werneckpaiva/TankEsp32/3d-model/.superpowers/sdd/2026-10-20-gimbal-head/progress.md

# SDD ledger — plan: esp32s3cam/docs/superpowers/plans/2026-10-20-gimbal-head.md
Spec: esp32s3cam/DESIGN.md
Setup: Ruling: no git repo — ledger kept by hand, no commits/BASE, task-start/task-done scripts not used; completion = suite run recorded here — cost if wrong: no per-task diff history (user can git init later)
Pre-flight:
- T2→T3..T7 components frames (board/servo/bearing/horn) — consistent
- T3→T4 NECK_TOP_Z, PAN_SERVO_LOC — consistent
- T4→T5 STUB_D(b), PAN_BEARING_LOC — consistent
- T5→T6 ARM_INNER_X — consistent
- T6→T7 BOARD_LOC/SR04_LOC/LASER_LOC + components.sd_access/usb_plug — consistent
- T8→T9 printed_parts(), NEEDS_SUPPORT — consistent
- Modules must read params via `import params as p` (T7 note) — applies to all tasks
Task 1: complete (tests: ../.venv/bin/python -m pytest tests -q → 4 passed)
Task 2: complete (tests: ../.venv/bin/python -m pytest tests -q → 12 passed). Added test_board_sd_on_plus_x_side, test_horn_hub_on_axis (extra coverage).
Task 3: Ruling: neck is a round drum (inner r = max(servo-tab reach 22.5+FIT, coupler sweep+MOVE_CLR, wire slot)) lofting out from the plate outline; it overhangs the plate (≈Ø49) — a narrow neck cannot hold the tabs and the horn sweep and leave a wire path — cost if wrong: bulkier "turret ring" look; plate footprint/holes unchanged.
Task 3: Ruling: plan's test_footprint/test_long_axis_switch bbox asserts replaced by z=1 plate-outline probes + bbox ≤ drum Ø — drum overhangs by design — cost if wrong: none functional.
Task 3: Ruling: long-axis switch rotates the whole base incl. servo pose; added pan_servo_loc(long_axis), PAN_SERVO_LOC = default — servo must follow the plate's long side — cost if wrong: one function.
Task 3: Ruling: pan servo stands on the plate top, held by tab screws into a front pillar and a rear ledge off the drum wall (rear pillar would block its cable exit) — cost if wrong: re-shape a ledge.
Task 3: complete (tests: ../.venv/bin/python -m pytest tests -q → 23 passed)
Task 4: Ruling: wires cross the pan joint through a hole in the co-rotating horn coupler and an arc slot in the neck-cap ceiling over the FRONT half (rear is crowded by the servo/tabs); test probes rotated to +Y and taken at pan.WIRE_SLOT_Z (ceiling) instead of NECK_TOP_Z+1 — cost if wrong: wire path rework.
Task 4: Ruling: the stub belongs to the coupler (passes up through the bearing), the yoke has a keyed socket fixed by one central M2 screw; no horn centre screw (bearing stack holds the horn on the spline). STUB_D(b) kept as the shared dimension — cost if wrong: horn could creep off the spline if the stack is loose.
Task 4: Ruling: components.mg90s_horn(grow=0.0) gains a grow parameter to cut pockets with FIT — cost if wrong: none.
Task 4: complete (tests: ../.venv/bin/python -m pytest tests -q → 33 passed)
Task 5: Ruling: added params.HEAD_WALL; ARM_INNER_X = SR_W/2 + FIT + HEAD_WALL + MOVE_CLR so the whole head (eye section is the widest) fits between the arms and the arms never meet the head at any tilt — cost if wrong: ~82 mm overall width instead of ~72.
Task 5: Ruling: no printed load ring around the tilt servo horn (spec "should") — the head sits between a bearing and the MG90S output (which has its own bearing); a ring would need a large-diameter sliding face inside the horn sweep — cost if wrong: some radial load on the tilt servo shaft.
Task 5: bug found in Task 4 code (stub flat box mis-aligned, cut half the stub) — test_stub_has_one_flat RED→GREEN.
Task 5: complete (tests: ../.venv/bin/python -m pytest tests -q → 44 passed). TILT_AXIS_Z uses HEAD_DROP=28 mm, to be tuned in Task 7.
Task 6: Ruling: the +X axle collar (touches the tilt bearing's inner ring) is exempt from test_fits_between_arms; the test excludes a cylinder of r = bore/2 + 1.5 around the tilt axis — the collar is the intended joint — cost if wrong: none.
Task 6: Ruling: no ribs pressing the camera board from behind (they would sit in the Dupont bay); the board is held on snug standoff pins and the plugs push it forward. HC-SR04 is held by its cans against the front wall + pegs on the rear cover at its corners — cost if wrong: a dab of glue.
Task 6: Ruling: components.hcsr04_keepout back box shrunk to the component area (corners are mounting-hole area, free) so the pegs can press the corners — cost if wrong: none.
Task 6: Ruling: rear cover = back plate only (split at the back wall's inner face) so no functional pocket is split across parts; horn pocket tilted 35° in the YZ plane to fit inside the head depth/height — cost if wrong: none.
Task 6: complete (tests: ../.venv/bin/python -m pytest tests -q → 60 passed). Body half-width widened by 1 mm for cover-screw posts; inner cavity corners square, outer rounding 2.5 mm.
Task 7: tuned yoke.HEAD_DROP 28 → 26 mm (24 fails at tilt −45° with 0.07 mm gap, 25 is the sampled minimum; 1 mm kept for angles between the 15° samples). Verified the motion test detects clashes (drop 18/22 → gaps 0.00).
Task 7: complete (tests: ../.venv/bin/python -m pytest tests -q → 96 passed; run_checks passes)
Task 8: found 0.2 mm floor under the yoke's central screw head — test_screw_head_has_a_floor RED→GREEN by BAR_T = SOCKET_DEPTH + 3.5 (was +2); head rises 1.5 mm.
Task 8: complete (tests: ../.venv/bin/python -m pytest tests -q → 105 passed; gimbal_head.py ran: checks pass, 6 STLs written, viewer not running → logged, exit 0). Ruling: yoke prints lying on its servo arm's outer face (its foot gives <50 mm² of bed contact upright) — cost if wrong: a reprint orientation choice in the slicer.
Task 9: complete (tests: ../.venv/bin/python -m pytest tests -q → see final run; make_3mf.py → gimbal_head.3mf, 1 plate, ~5.2 h, 84 g PLA)
Final review: fresh reviewer (opus). 2 Critical, 9 Important, ~12 Minor. Re-graded: C1 wire path across tilt joint, C2 floating posts → fix. I3 assembly order, I4 pan key backlash, I5 wire hole sizing/margin, I6 HEAD_DROP derived, I7 face-down print on brows, I8 bushing binding, I9 servo cable hole, I10 tab-screw length → fix. I11 overall height 143 mm → user decision (Ruling below).
Final: fixed C1 wire path across tilt joint — wires now cross the pan joint at WIRE_ANGLE=180 (-X); head exit in the underside straight above the yoke hole; 4 mm well around the hole; tilt-servo cable tunnel through the crossbar — test_head_wire_exit_above_yoke_hole, test_wire_corridor_never_pinched (fails at 0.93 mm without the well), test_servo_cable_tunnel_open RED→GREEN.
Final: fixed C2 floating cover posts — posts run into ceiling/floor — test_printed_parts_have_no_loose_pieces RED→GREEN.
Final: fixed I3 tilt/horn assembly order — docstring rewritten (horn into head pocket, axle, then servo slides in from outside; pan horn set on the spline first). Docs only, no test.
Final: fixed I4 pan key backlash — 2.0 mm flat with 0.1 mm fit — test_stub_key_has_little_play RED→GREEN (≤2°).
Final: fixed I5 wire holes — sized from WIRE_COUNT·WIRE_D at WIRE_FILL 0.4 and to pass a 3-pin plug, cap slot +15° margin each end — test_wire_hole_sized_for_bundle_and_plug, test_cap_slot_has_end_margin RED→GREEN. Pan horn pocket turned to WIRE_ANGLE+90 to clear the hole; cap ceiling 3 mm, seat lip 1 mm (spacer 1.5 mm).
Final: fixed I6 HEAD_DROP — derived from head.drop_below_axis() (2.5° sweep); head no longer imports yoke — test_rebuilds_with_perturbed_params[BAY_DEPTH] RED→GREEN (also now checks tilt overlap).
Final: fixed I7 face-down print — brow rings are a separate part plugged into the eye openings — test_head_front_face_lies_on_the_bed RED→GREEN.
Final: fixed I8 pan bushing binding — bushing 0.6 mm shorter than the bearing (stub bottoms out first) — test_bushing_is_shorter_so_it_is_not_clamped RED→GREEN.
Final: Ruling: tilt bushing can still be clamped by the M3 axle — documented "don't overtighten" instead of redesigning the axle stack — fallback mode only, bearings are the default — cost if wrong: stiff tilt in bushing mode.
Final: fixed I9 pan-servo cable hole — 8.5 × 4.5, 2.5 mm from the plate edge — test_servo_cable_hole_takes_plug_and_keeps_an_edge RED→GREEN.
Final: fixed I10 tab screws — docstring limits them to 6 mm. Docs only.
Final: Ruling: I11 overall height ~145 mm vs 110–125 target — left to the user (needs a design change: sinking the pan servo into the tank cover, or a shorter stack) — cost if wrong: looks tall on the tank.
Final: minor (deferred): camera board held only by snug pins (no rear retention)
Final: minor (deferred): HC-SR04 pegs 2×2×22 mm are fragile
Final: minor (deferred): HC-SR04 cans sit behind the face (brow rings now frame them)
Final: minor (deferred): neck-cap screw counterbores leave ~0.14 mm outer wall
Final: minor (deferred): pan seat hangs from a partial ceiling (ceiling now 3 mm, lip 1 mm)
Final: minor (deferred): 623 shields may rub on collar / M3 head
Final: minor (deferred): TILT_AXLE_D unused; axle pilot fixed at Ø2.5
Final: minor (deferred): yoke prints tall on a narrow face (brim advised in docstring)
Final: minor (deferred): large flat −X side face runs 0.5 mm from the arm
Final: minor (deferred): no laser-vs-eye test
Final: minor (deferred): Dupont bay measured from PCB front (28.4 mm behind the board)
Final: suite 134/134 passed; gimbal_head.py motion checks pass, 7 STLs written; gimbal_head.3mf 1 plate ~5.1 h, 82 g PLA. Ruling: ledger kept (no git history to replace it).
Change (user): tilt bearing 623 → 608 (user has five 8x22x7). Ruling: tilt axle is now a separate printed pin through the 608 into a head socket, M3x25 bolt + nut inside the head; small-bore screw-axle variant dropped (bore ≥ 6 asserted) — a pin fixed to the head could not be inserted between the arms — cost if wrong: a bearing < 6 mm bore needs the old axle back. Horn pocket angle 35° → 22° (head bottom rose ~6 mm with the larger pin-arm boss). Tests RED first: test_bearing_defaults, test_axle_socket_and_bolt_hole, test_collar_touches_inner_ring_only, test_tilt_axle_fits, test_fits_between_arms, test_horn_pocket_inside_head (guard).
Change: tilt socket deepened to the pin's real length (test_tilt_axle_fits RED→GREEN). Suite 140/140; motion checks pass; 8 STLs; 3MF ~5.6 h, 91 g. Overall 83.2 × 48.7 × 145.3 mm.
Change (user): support optimisation. Measured with the slicer per part (supports on vs off): yoke 11.1 g / 40 min, head_front 1.3 g / 10 min, others ≤ 0.6 g.
- Ruling: the slim +X arm is now a separate part (pin_arm) bolted to the crossbar with 2 x M3 x 12 from below — lying on its side the yoke had a 48 mm cantilever 75 mm above the bed — cost if wrong: a bolted joint instead of one piece.
- Yoke hub: round hub → 45° shouldered hub around the wire well. Head front: 45° chamfers on the face/back outlines (edges along Y still rounded), horn bar run square to the face, 1.25:1 tapered post ends, full-length laser clamp ear block, teardrop axle boss.
- Tests: test_prints_without_support[yoke|pin_arm|head_front], test_cantilevers_are_gone, test_pin_arm_bolts_to_the_crossbar, test_tall_yoke_gets_a_brim RED→GREEN. Metric fix: angle convention (45° chamfers are fine) and small hole ceilings (r ≤ 4.5) are bridged.
- Result: no part needs supports; yoke gets a 5 mm brim. Plate: 77.6 g, 4.8 h (was 91.3 g, 5.6 h), used_for_support=false. Suite 154/154.
Change (user): yoke supports enabled in the 3MF (tree, build plate only); test_support_settings RED→GREEN. Plate 79.7 g, 5.0 h.
Change (user): base flare 45-49° → 40° from vertical inside and out (test_prints_without_support[base] RED→GREEN after tightening the test to < 10 mm² for every bare part); brims on yoke + tilt_axle from a height/√(bed contact) check (test_brims_where_parts_are_tall_for_their_footprint RED→GREEN). Suite 161/161; 3MF 79.8 g, 5.0 h; only slicer warnings left are the timelapse notices.
Change (user): base supports enabled (test_support_settings RED→GREEN).
Change: base floating starts fixed — rear tab ledge clipped to the drum's outside, neck-cap boss cones start at r 1.0 so they grow from the wall (test_base_has_no_floating_starts RED→GREEN, 19 s slice test). Base supports stay enabled at the user's request.
Change (user): stringing over holes on neck cap + brows. Neck-cap bearing lip → 0.6 mm flat step + 45° slope (test_bearing_lip_has_no_mid_air_ledge RED→GREEN); brow flange → 40°-from-vertical slope under it (test_brow_flange_slopes_instead_of_a_mid_air_ledge RED→GREEN); 3MF process: reduce_crossing_wall=1 (test_travel_avoids_crossing_holes; make_3mf.py now has a main() guard). Suite 164/164. Versus the printed 3MF: brows, neck_cap changed (this fix); base changed slightly (earlier floating-start edits, kept); all others identical.
Change (user): MG90S cable leaves the shaft end (not the far end). Base: front pillar is now an arch over the cable (ARCH = plug + clearance), cable runs to the plate's front cable hole; rear SERVO_CABLE_HOLE removed. Tilt servo checked: its cable exits into the open tab slot of the yoke arm — no change. Tests: test_pan_servo_cable_runs_under_the_front_pillar RED→GREEN, test_front_tab_screw_still_has_plastic, cable-hole sizing now includes the servo's 3 wires. Suite 165/165. Assembly guide PDF and docstring updated.
Change (user): HC-SR04 fit. User dims match params (45x20, Ø16, 10 mm gap = 26 c-c). Cause: top rear-cover posts sat in the sensor's insertion path (sweep test); board clearance only 0.25 mm. Fix: params.SR_CLR=0.5 (eye side walls 1.35 so the outside and the yoke are unchanged), board located by 4 front ribs (cans ≤ SR_TX_H+0.5 clear the wall), top cover screws now from above through the top wall into tabs on the rear cover. Tests: test_hcsr04_slides_in_from_the_open_back, test_hcsr04_has_printable_clearance, test_hcsr04_board_stops_against_front_ribs, test_rear_cover_screws_from_the_top RED→GREEN. Suite 169/169. Reprint vs printed: head_front, head_rear (+ base, neck_cap, brows from earlier fixes).
Change (user): camera alignment. Lens/LED positions measured by the user (lens centre 15.37 from left, 9.03 from top; LEDs at 9.0 and 23.4). Camera stands ~7.5 mm (block) + barrel ~8.7 mm off the board (side-photo estimate), so it hit the inside of the face (5.5 mm) and tilted the board's top end off its pins. Fix: params updated (CAM_H → CAM_BLOCK_H/LENS_TIP_H, LENS_D/LENS_D_FRONT, LED_W, VISOR_CLR), head face gap decoupled from camera height (FACE_GAP 5.5, outside unchanged), round lens + LED windows replaced by one visor window. Tests: measured values, test_visor_opens_the_face_for_the_camera_and_leds, test_outside_unchanged... RED→GREEN; suite 171/171. Reprint: head_front only.
Change (user): camera opening is now =O= (round Ø13 hole the square camera block passes through + a slot to each LED), test_camera_opening_is_round_with_led_slots RED→GREEN. New optional fit-test piece (face only: openings, board pins, HC-SR04 ribs) built from the same face_mounts()/face_openings() as the head; exported separately as gimbal_fit_test.stl, not on the main plate. Tests: test_fit_test_is_one_flat_piece, test_fit_test_matches_the_head, test_fit_test_exported_on_its_own. Suite 174/174.
Change (user): HC-SR04 cans stand out CAN_OUT=1.5 mm (SR_Y = Y_FRONT + CAN_OUT - SR_TX_H; plug keepout thickness corrected to the 2.54 mm Dupont housing; plugs keep 1.0 mm from the camera board), eye openings pass the cans, brows are plain tubes seated in a 0.8 mm recess. Fit test is now head_front cut just behind both boards (walls included, FIT_TEST_Y0). Status LED (centre 6,3 from top-left, 2 mm) window + light path through the top-left standoff; LED_WIN_CLR 1.0 margin on every LED window. Tests: test_eye_cans_stand_out_of_the_face, test_hcsr04_plugs_clear_the_camera_board, test_brows_sit_around_the_cans, test_fit_test_is_the_front_of_the_head, test_board_has_the_status_led, test_every_led_shows_through_the_face RED→GREEN. Suite 180/180. Reprint vs printed: head_front, head_rear, brows.
Change (user, after fit test): camera board FACE_GAP 5.5 → 4.8 (BAY_DEPTH 30.0 → 30.7 keeps DEPTH 38.7, yoke unchanged); measured LENS_TIP_H 7.05, USB_H 3.25, SD_SHELL_H 3.2 (was 2.0); CAM_BLOCK_H estimate lens-1.0; O = block circumscribed + 0.25 (Ø12.5); LED_Y 7.5 → 6.5; SD slot +SD_CLR 0.5; HC-SR04 held by 4 corner posts merged into walls/ceiling/floor + 4×M2×6 through its Ø2 holes (inset 1.6 from photo), rear-cover pegs and face ribs removed; 3MF nozzle 210 °C + avoid crossing walls, plus gimbal_fit_test.3mf. Tests RED→GREEN: test_measured_board_heights, test_camera_board_close_to_the_face, test_o_is_as_small_as_the_camera_block_allows, test_hcsr04_screws_to_corner_posts, test_sd_slot_has_extra_margin, test_print_settings_against_stringing, test_fit_test_has_its_own_project. Suite 186/186. Reprint: head_front, head_rear, brows.
Change (user): axle boss now starts at the head's wall (was 0.2 mm from the right header's Dupont plugs); esp32_keepout gained a header-plug zone (+1 mm beside the plugs); camera board pinned at two diagonal corners and screwed (M2x6) at the other two; rear cover has a 1.2 mm locating lip (0.2 clearance, 3 mm deep, top and sides). Exploded tilt-joint drawing added to the guide. Tests RED→GREEN: test_keepout_leaves_room_beside_the_header_plugs, test_camera_board_screwed_at_two_corners_pinned_at_two, test_rear_cover_has_a_locating_lip. Suite 189/189. Reprint: head_front, head_rear, brows. Depth question open (user decision).
