werneckpaiva/TankEsp32/3d-model/3mf/printed/2026-10-21_round_lens_window.3mf

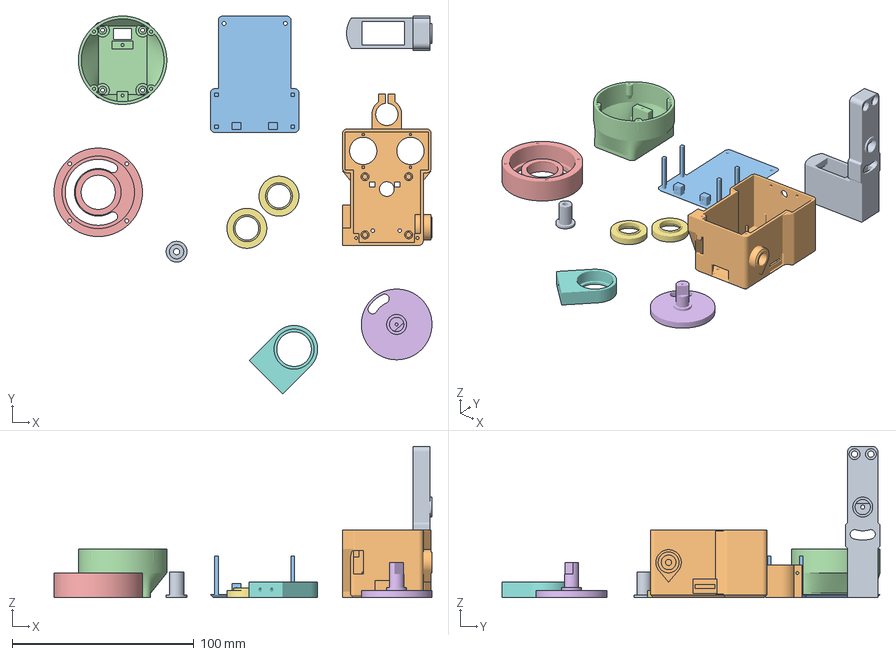
[picture p1: CAD file, 2026-10-21]
3d-model/3mf/printed/2026-10-21_round_lens_window.3mf
208.0 x 208.0 x 83.2 mm
gimbal_yoke.stl
gimbal_head_front.stl
gimbal_head_rear.stl
gimbal_base.stl
gimbal_neck_cap.stl
gimbal_pan_coupler.stl
gimbal_brows.stl
gimbal_pin_arm.stl
gimbal_tilt_axle.stl
