werneckpaiva/TankEsp32/3d-model/3mf/reference/gimbal.3mf

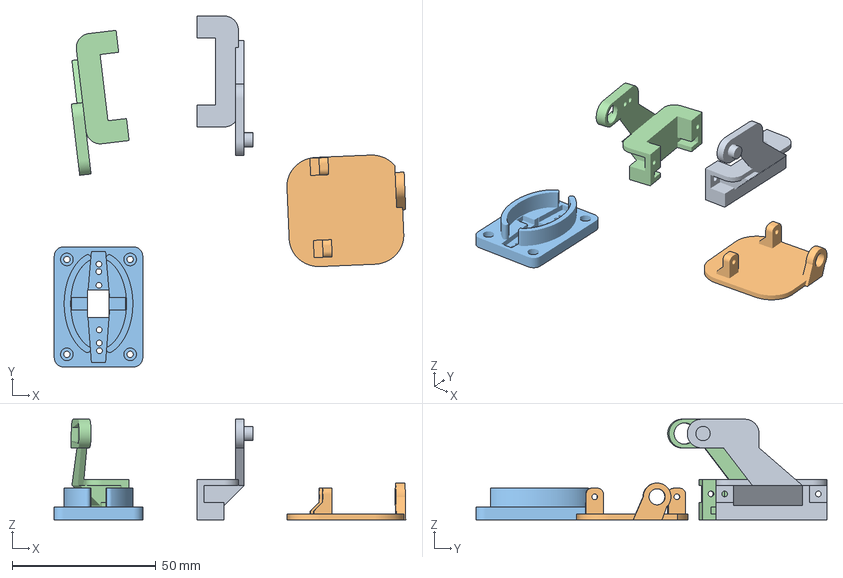
[picture p2: CAD file, 2026-10-21]
3d-model/3mf/reference/gimbal.3mf
122.2 x 122.1 x 35.0 mm
HolderL.stl
base.stl_1
base.stl_2
HolderR.stl
