werneckpaiva/TankEsp32/(commit log)

2022-04-15 Adds motor driver support
2026-10-21 Add the 3D-printed camera head gimbal model
    A build123d model of the pan/tilt "moving head" for the tank: an
    ESP32-S3-CAM, an HC-SR04 as the eyes and an SYD1230 laser, on two MG90S
    servos with 608 bearings. It includes about 190 geometric tests, a
    Bambu Studio project builder and the assembly guide generator.
    - 3d-model/ is split into python/ (model, tests, tools), stl/, 3mf/
    (printed/ baselines and the reference gimbal) and docs/.
    - AGENTS.md merges the original design spec with the working notes.
    - gimbal.sh in the repo root runs the viewer, builds the STLs and
    builds the 3MFs, using the root .venv (deps in requirements.txt).
    - Generated outputs (STLs, sliced 3MFs, guide PDF and drawi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
2026-10-21 Re-enable wheels motor and gimbal controllers
2026-10-21 Stop spin states from spinning with a forward/backward event's speed
    SpinningRight/SpinningLeft handled movement.forward and movement.backward
    by casting them to spin events and spinning with their horizontal speed.
    That speed can have the wrong sign (e.g. throttle forward with the stick
    slightly left while spinning right), which made spinRight/spinLeft pass a
    negative duty to ledcWrite, wrapping to a huge unsigned value. Throttle
    input also kept the tank spinning instead of driving.
    Forward/backward now stop the spin, mirroring how forward/backward
    reversals already pass through Stopped. The next forward/backward event
    (at the latest the 500 ms RC resend) starts the move from Stopped.
2026-10-21 Raise listener task stack to 3 KB and report its high-water mark
    Static analysis (-fstack-usage plus the entry frame sizes of the
    precompiled newlib/IDF functions) puts the deepest listener path at
    ~1.3 KB of frames: Serial.printf from inside a transition reaches
    newlib's _svfprintf_r, whose frame alone is 784 bytes. With the
    FreeRTOS context and FPU save area that is ~1.6-1.7 KB of the previous
    2 KB, too little headroom for e.g. a %f in a log line. 3 KB costs 4 KB
    of heap for the four listeners.
    EventListener now keeps its task handle and exposes
    getStackHighWaterMark(); printStatus logs it for every controller so
    the real usage can be checked on the device.
2026-10-21 Add AGENTS.md and architecture docs with Mermaid diagrams
    AGENTS.md gives coding agents the build commands, layout, EventDrivenStates
    semantics, wiring and known gotchas. docs/ARCHITECTURE.md diagrams the
    event flow, event/state ownership, framework classes and every state
    machine.
2026-10-21 Route all debug output through DEBUG_PRINTF/DEBUG_PRINTLN macros
    The macros live in EventDrivenStates.h and compile to nothing, arguments
    included, unless DEBUG_MODE is defined. The flag is set once in
    platformio.ini build_flags so it applies to both src/ and lib/. The
    printStatus task only exists in debug builds. A build without
    DEBUG_MODE drops every debug string and is 1.9 KB smaller.
    Removes the unfinished src/debug.h stub, which did not compile and was
    not included anywhere.
2026-10-21 Name the RC channels and their value ranges
    RCMonitoringState now reads TURN/THROTTLE/TILT/PAN/LIGHTS_SWITCH
    channels into turnSpeed, throttleSpeed, tiltAngle, panAngle and
    lightsOn instead of ch0..ch4, with MAX_SPEED/MAX_ANGLE/CENTER_ANGLE in
    place of literals. RCDriver names its pulse-width limits and renames
    redSwitch to readSwitch. The last-read values are now protected.
    The compiled code is byte-identical to before.
2026-10-21 Name the gimbal and movement magic numbers
    ManualControlState gets MAX_ANGLE, CENTER_ANGLE, SERVO_MIN/MAX_ANGLE and
    MIN_ANGLE_CHANGE, and SpinningLeftState gets MIN_SPEED_CHANGE, in place
    of literals. Documents that direction changes go through StoppedState.
    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
2026-10-21 Document WheelsMotorDriver and drop the undefined turn() declaration
    Explains which motor is which track, which H-bridge input drives each
    direction, and the sign each method expects (spinLeft takes the negative
    stick value). turn() was declared but never defined or used.
    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
